ziyul893/ece4180-programmable-power-supply/(threads)

Thread 1 (2024-08-31):

programmatically turn on and off?

karu2003, 2024-08-31:
Hello, two questions about your project.
Is it possible to smoothly set the voltage from 12 to 20V. For example, 17V.
Is it possible to programmatically turn on and off, and change the voltage.
I need the display and buttons secondarily.
