ziyul893/ece4180-programmable-power-supply/(commit log)

2022-12-09 edit webpage and add schematic
2022-12-09 Update Schematic
2022-12-09 add pcb layout
2022-12-09 add bread board connection
2022-12-10 update 3 relay photo
2022-12-10 fix wiring
